zakharovjs/gsm-water-level-meter/docs/commands.md

#### Основные команды для управления устройством через SMS

Для получения значений уровня воды, температуры, расстояния до поверхности или значения высоты абсолютного уровня оператору достаточно отправить SMS-сообщение с соответствующей командой.

| Команда управления | Расшифровка |
| --- | --- |
| `SetThisNumber` | Сохранение номера в энергонезависимую память и отправка данных со всех датчиков и модулей. |
| `T` | Запрос данных с датчика температуры. |
| `R` | Данные, полученные с ультразвукового датчика расстояния. |
| `ObratnoeR` | Значение высоты, на котором установлено устройство, задаваемое для расчета уровня воды в зависимости от расстояния, получаемого с ультразвукового датчика. |
| `Glubina` | Значение уровня воды. |

По событию приема сообщения «SetThisNumber» через GSM-модуль, микроконтроллер сохраняет номер телефона в энергонезависимую память и отправляет данные со всех датчиков. Данный номер в дальнейшем будет использоваться в режиме автономной работы устройства. После режима ожидания сообщений микроконтроллер переводит GSM-модуль в режим низкого энергопотребления (спящий режим) и переходит в режим автономной работы, в котором в зависимости от выставленного значения времени (1 мин.-1 ч.) устройство просыпается и отправляет данные с датчиков на сохраненный номер
