zakharovjs/gsm-water-level-meter/images/screenshot.png

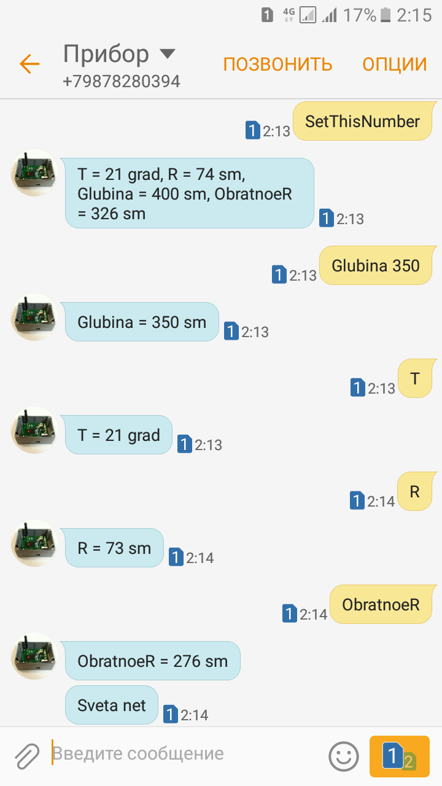
images/screenshot.png
