zakharovjs/gsm-water-level-meter/docs/components.md

# СПИСОК КОМПЛЕКТУЮЩИХ ДЛЯ ИЗМЕРИТЕЛЯ РАССТОЯНИЯ И ТЕМПЕРАТУРЫ

## 📦 Основные компоненты

| № | Компонент | Метки | Кол-во |
| --- | --- | --- | --- |
| 1 | Корпус Gainta G311 | – | 1 |
| 2 | Датчик расстояния HC-SR04 | – | 1 |
| 3 | Датчик температуры DS18B20 в корпусе с кабелем | – | 1 |
| 4 | GSM-антенна 50 Ом SMA001 гайка+штырь (напр., 315M-XJT) | – | 1 |
| 5 | Кнопка тактовая 6x6 мм, 4 контакта без заземления (напр., KAN0611-0501) | PowerKey | 1 |
| 6 | Держатель SIM-карты MOLEX 91228-3001 | SIM | 1 |
| 7 | Лоток держателя SIM-карты MOLEX 91236-0001 | SIM | 1 |

## 🔌 Разъёмы, колодки, штыри и провод

| № | Компонент | Метки | Кол-во |
| --- | --- | --- | --- |
| 8 | Разъём SMA KLS1-SMA001 штуцер (вилка на плату) | Антенна | 1 |
| 9 | Разъём WF-2 | Питание, Тревога | 2 |
| 10  | Разъём WF-3 | DS18B20, SIM+МК  | 2 |
| 11  | Разъём WF-4 | HC-SR04 | 1 |
| 12  | Разъём WF-5 | ICSP | 1 |
| 13  | Разъём HU-3 (для датчика DS18B20) | – | 1 |
| 14  | Разъём HU-4 (для датчика HC-SR04) | – | 2 |
| 15  | Разъём USBB-1J на плату | J_USB | 1 |
| 16  | Кабель 4-жильный сигнальный (для датчика HC-SR04) | – | 1–2 м  |

## ⚡ Микросхемы и колодки

| № | Компонент | Метки | Кол-во |
| --- | --- | --- | --- |
| 17  | Модуль SIM900D | U1 | 1 |
| 18  | PIC16F628A DIP-18 | U2 | 1 |
| 19  | FT232RL SSOP-28 | U3 | 1 |
| 20  | LM317T TO-220 | U4 | 1 |
| 21  | Оптрон 6N137 DIP8 | VO1, VO2 | 2 |
| 22  | Колодка DIP8 (напр., SCS-8) | VO1, VO2 | 2 |
| 23  | Колодка DIP18 (напр., SCS-18) | U2 | 1 |

## 🔧 Резисторы

| № | Компонент | Метки | Кол-во |
| --- | --- | --- | --- |
| 24  | 0805 0 Ом | R4, R5 | 2 |
| 25  | 0805 22 Ом | R1, R2, R3 | 3 |
| 26  | 0805 510 Ом  | R16, R18 | 2 |
| 27  | 0805 820 Ом  | R14 | 1 |
| 28  | 0805 1 кОм | R7, R9, R10, R20, R21 | 5 |
| 29  | 0805 2.2 кОм | R15 | 1 |
| 30  | 0805 4.7 кОм | R8 | 1 |
| 31  | 0805 5.1 кОм | R12, R13, R17, R19 | 4 |
| 32  | 0805 10 кОм  | R22 | 1 |
| 33  | 0805 27 кОм  | R6, R11, R23 | 3 |

## 🔋 Конденсаторы

| № | Компонент | Метки | Кол-во |
| --- | --- | --- | --- |
| 34  | 0805 22 пФ | C2 | 1 |
| 35  | 0805 0.1 мкФ | C1, C7, C8, C10–C12, C14 | 7 |
| 36  | 1206 4.7 мкФ | C6 | 1 |
| 37  | Электролит 4.7 мкФ 16 В (между выводами 2.54) | C13 | 1 |
| 38  | Электролит 100 мкФ 10 В (между выводами 2.54) | C5 | 1 |
| 39  | Электролит 1000 мкФ 10 В (между выводами 3.81 мм) | C9 | 1 |

## 💡 Диоды и светодиоды

| № | Компонент | Метки | Кол-во |
| --- | --- | --- | --- |
| 40  | SMF05CT1G | D1 | 1 |
| 41  | Диод 1N4007 | D4 | 1 |
| 42  | Диод 1N4148W SOD-123 | D2, D3, D5, D6, D7 | 5 |
| 43  | Светодиод синий прозрачный 5 мм (напр., 5013UBC) | NetLight | 1 |
| 44  | Светодиод зелёный прозрачный 5 мм (напр., 5013BGC) | Status | 1 |
