zakharovjs/gsm-water-level-meter/(list of files, drawings)

Other design files:
hardware/circuit.dch
hardware/PCB.dip
